Kmassidik/autonomous-computer/components/cpu/xeon-w5-3423/sources.md

# Sources — Intel Xeon w5-3423

Every dimension in `specs.json` and `index.html` traces to one of these.

## Autonomous 4×-6000 build README

- URL: <https://github.com/autonomous-ai/autonomous-computer/blob/main/4x-6000/README.md>
- Retrieved: 2026-10-02
- Covers: Core count, 112 PCIe 5.0 lanes, socket, stock cooler part number

## ASUS Pro WS W790E-SAGE SE tech spec

- URL: <https://www.asus.com/motherboards-components/motherboards/workstation/pro-ws-w790e-sage-se/techspec/>
- Retrieved: 2026-10-02
- Covers: Socket LGA4677 compatibility

## Not vendor-published

- Package dimensions
- Substrate thickness used in CAD
- IHS modelled as

These are JEDEC/ATX standard values or modelling estimates. They are good enough for
clearance checking and should not be quoted as manufacturer specifications.
