Kmassidik/autonomous-computer/components/gpu/rtx-3060ti/sources.md

# Sources — GeForce RTX 3060 Ti

Every dimension in `specs.json` and `index.html` traces to one of these.

## NVIDIA RTX 3060 / 3060 Ti product page

- URL: <https://www.nvidia.com/en-us/geforce/graphics-cards/30-series/rtx-3060-3060ti/>
- Retrieved: 2026-10-02
- Covers: Length, width, slot count, TGP, memory, bus width

## Not vendor-published

- Slot pitch used in CAD

These are JEDEC/ATX standard values or modelling estimates. They are good enough for
clearance checking and should not be quoted as manufacturer specifications.
