Kmassidik/autonomous-computer/components/gpu/rtx-5090/sources.md

# Sources — GeForce RTX 5090

Every dimension in `specs.json` and `index.html` traces to one of these.

## NVIDIA GeForce RTX 5090 product page

- URL: <https://www.nvidia.com/en-us/geforce/graphics-cards/50-series/rtx-5090/>
- Retrieved: 2026-10-02
- Covers: Length, width, slot count, TGP, memory, power connectors

## Not vendor-published

- Slot pitch used in CAD

These are JEDEC/ATX standard values or modelling estimates. They are good enough for
clearance checking and should not be quoted as manufacturer specifications.
