Kmassidik/autonomous-computer/components/gpu/rtx-pro-6000/sources.md

# Sources — RTX PRO 6000 Blackwell

Every dimension in `specs.json` and `index.html` traces to one of these.

## NVIDIA RTX PRO 6000 product page

- URL: <https://www.nvidia.com/en-us/products/workstations/professional-desktop-gpus/rtx-pro-6000/>
- Retrieved: 2026-10-02
- Covers: Dimensions, power, memory, bandwidth, connectors, cooling

## PNY RTX PRO 6000 Blackwell WS

- URL: <https://www.pny.com/nvidia-rtx-pro-6000-blackwell-ws>
- Retrieved: 2026-10-02
- Covers: Confirms 5.4 in × 12 in dual slot; power connector type

## Not vendor-published

- (none)

These are JEDEC/ATX standard values or modelling estimates. They are good enough for
clearance checking and should not be quoted as manufacturer specifications.
