Kmassidik/autonomous-computer/components/motherboard/asus-pro-ws-w790e-sage-se/sources.md

# Sources — ASUS Pro WS W790E-SAGE SE

Every dimension in `specs.json` and `index.html` traces to one of these.

## ASUS Pro WS W790E-SAGE SE tech spec

- URL: <https://www.asus.com/motherboards-components/motherboards/workstation/pro-ws-w790e-sage-se/techspec/>
- Retrieved: 2026-10-02
- Covers: Form factor and dimensions, socket, PCIe slot configuration, memory slots, capacity, supported types and speeds

## Not vendor-published

- PCB thickness used in CAD

These are JEDEC/ATX standard values or modelling estimates. They are good enough for
clearance checking and should not be quoted as manufacturer specifications.
