Kmassidik/autonomous-computer/components/ram/ddr5-4800-ecc-rdimm/sources.md

# Sources — DDR5-4800 ECC RDIMM

Every dimension in `specs.json` and `index.html` traces to one of these.

## Wikipedia — DIMM (JEDEC figures)

- URL: <https://en.wikipedia.org/wiki/DIMM>
- Retrieved: 2026-10-02
- Covers: 288-pin, 31.25 mm nominal height, 133.35 mm length, standard MO-329J

## ASUS Pro WS W790E-SAGE SE tech spec

- URL: <https://www.asus.com/motherboards-components/motherboards/workstation/pro-ws-w790e-sage-se/techspec/>
- Retrieved: 2026-10-02
- Covers: 8 DIMM slots, 2048 GB max, 8-channel, DDR5 ECC Registered, speed list

## Not vendor-published

- PCB thickness used in CAD

These are JEDEC/ATX standard values or modelling estimates. They are good enough for
clearance checking and should not be quoted as manufacturer specifications.
