Kmassidik/autonomous-computer/components/cpu/xeon-w5-3423/index.html

Socket | Intel LGA4677 (Xeon W-3400 / W-2400)
Cores | 12
PCIe 5.0 lanes | 112 — enough for four cards at full ×16
Package dimensions | 77.5 mm × 56.5 mm unverified
Substrate thickness used in CAD | 1.1 mm estimate
IHS modelled as | 58 × 42 × 2.6 mm estimate
Stock cooler in BOM | Heatsink 4677-2UAF8 (2U active)
model.step — envelope | Block geometry at true outer dimensions. Small, fast, and all you need to answer does it fit.
model-detailed.step — detailed | 77.5 × 56.5 × 3.82 mm · 1771 faces · 11.3 cm³ · 2019 KB
Solid integrity | valid, closed manifold — boolean interference tests will work against it
Autonomous 4×-6000 build README (https://github.com/autonomous-ai/autonomous-computer/blob/main/4x-6000/README.md) | Core count, 112 PCIe 5.0 lanes, socket, stock cooler part number
ASUS Pro WS W790E-SAGE SE tech spec (https://www.asus.com/motherboards-components/motherboards/workstation/pro-ws-w790e-sage-se/techspec/) | Socket LGA4677 compatibility
