Kmassidik/autonomous-computer/2x-5090/assembly/housing-2x-box--RTX5090-and-RTXPRO6000.step

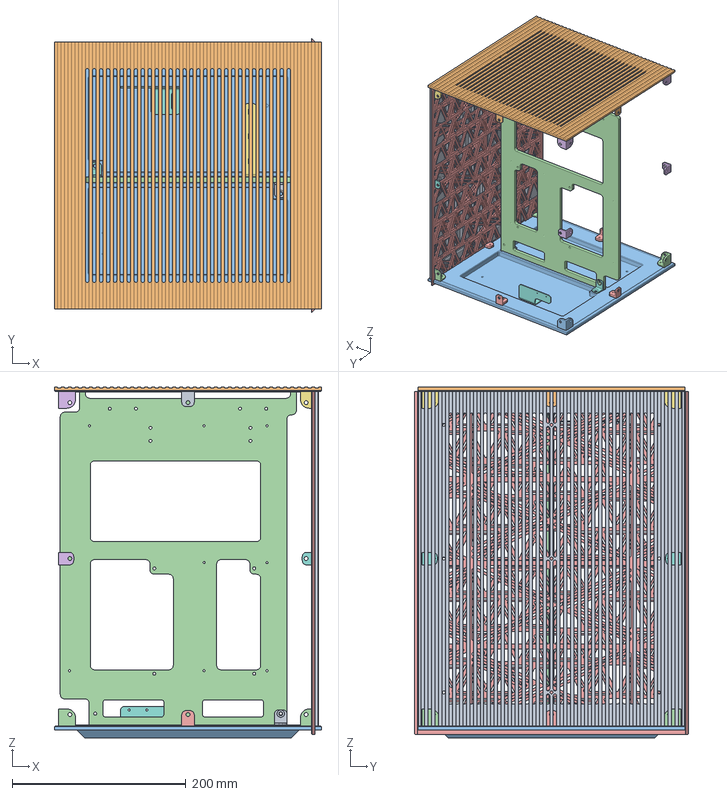
[picture p1: CAD file, 2026-10-02]
2x-5090/assembly/housing-2x-box--RTX5090-and-RTXPRO6000.step
307.6 x 315.0 x 404.0 mm
