Kmassidik/autonomous-computer/2x-5090/drawings/dxf/Part 5 - Middle.dxf

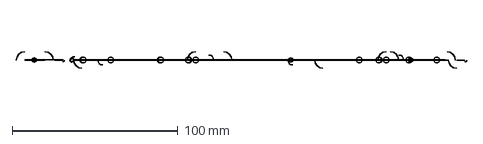
[picture p2: CAD file, 2026-10-02]
2x-5090/drawings/dxf/Part 5 - Middle.dxf
271.9 x 10.0 mm
