Kmassidik/autonomous-computer/4x-5090/assembly/housing-4x-cube--RTX5090-and-RTXPRO6000.step

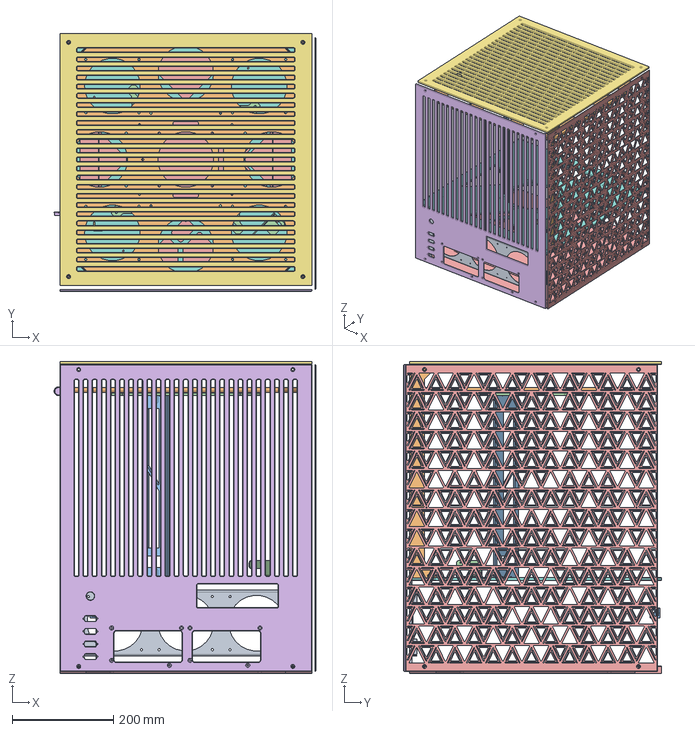
[picture p3: CAD file, 2026-10-02]
4x-5090/assembly/housing-4x-cube--RTX5090-and-RTXPRO6000.step
517.4 x 509.9 x 616.5 mm
