Kmassidik/autonomous-computer/4x-5090/drawings/dxf/Part 5 - Corner 1.dxf

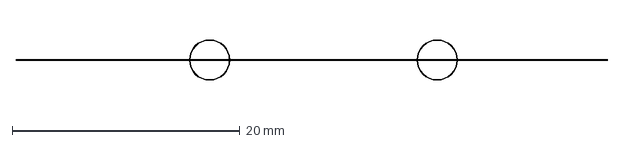
[picture p4: CAD file, 2026-10-02]
4x-5090/drawings/dxf/Part 5 - Corner 1.dxf
52.0 x 3.50 mm
