Kmassidik/autonomous-computer/4x-5090/step_models/Part 2 - Back--CORRECTED-placement.step

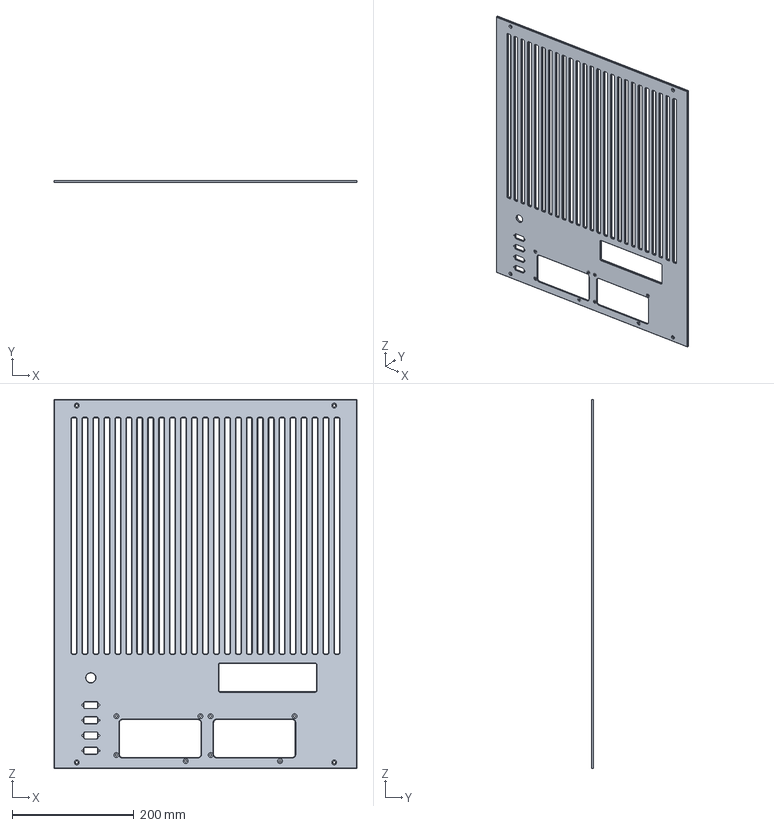
[picture p5: CAD file, 2026-10-02]
4x-5090/step_models/Part 2 - Back--CORRECTED-placement.step
498.0 x 4.00 x 606.5 mm
