Kmassidik/autonomous-computer/components/cpu/xeon-w5-3423/model.step

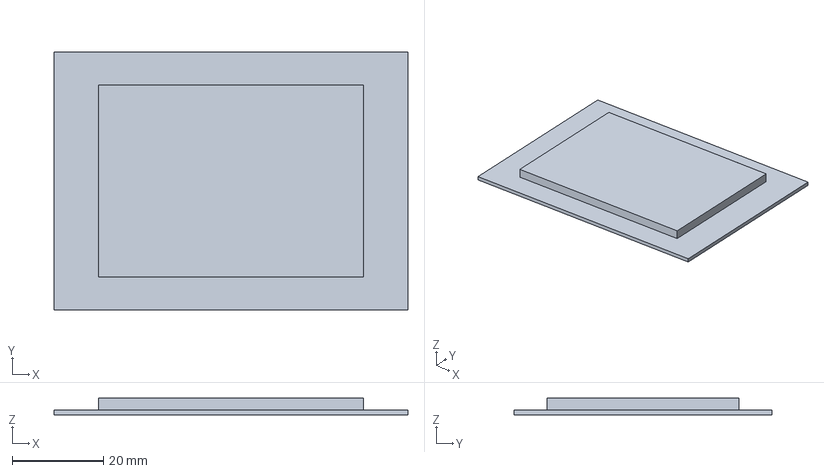
[picture p6: CAD file, 2026-10-02]
components/cpu/xeon-w5-3423/model.step
77.5 x 56.5 x 3.70 mm
