Kmassidik/autonomous-computer/components/gpu/rtx-3060ti/model.step

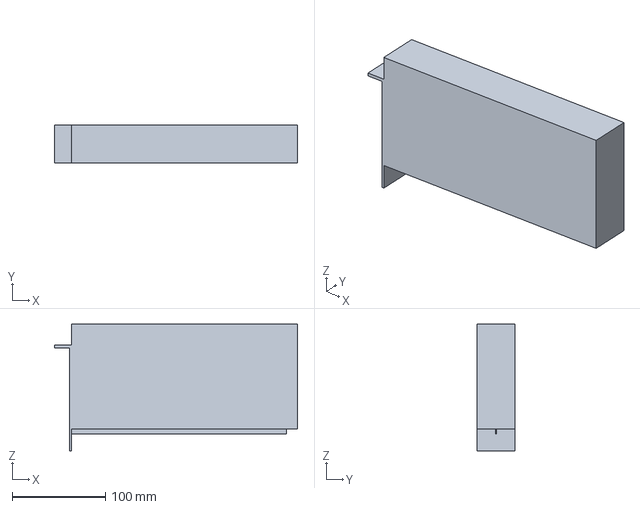
[picture p7: CAD file, 2026-10-02]
components/gpu/rtx-3060ti/model.step
260.0 x 40.6 x 135.6 mm
