Kmassidik/autonomous-computer/components/gpu/rtx-5090/model.step

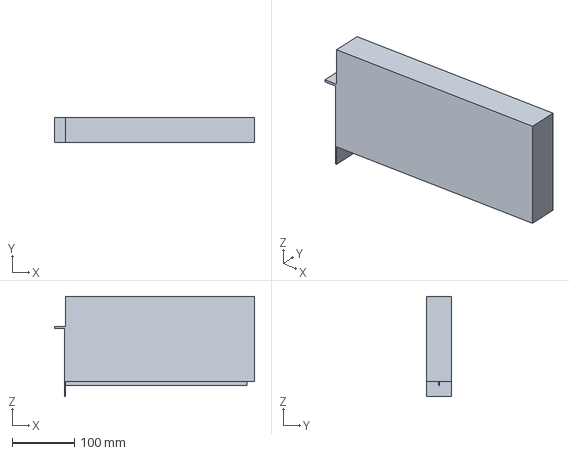
[picture p8: CAD file, 2026-10-02]
components/gpu/rtx-5090/model.step
322.0 x 40.6 x 161.8 mm
