Kmassidik/autonomous-computer/components/gpu/rtx-pro-6000/model-detailed.step

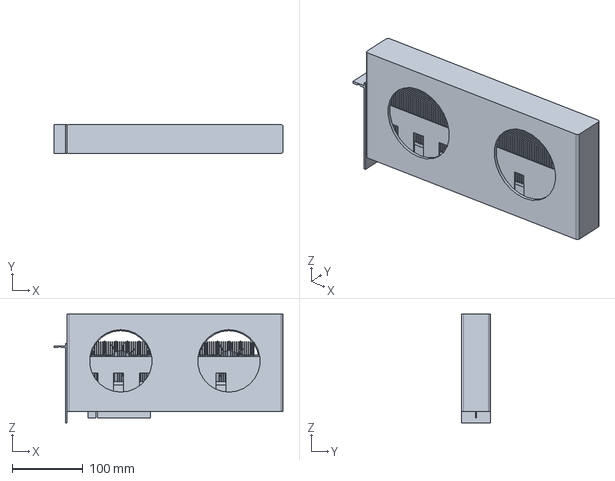
[picture p9: CAD file, 2026-10-02]
components/gpu/rtx-pro-6000/model-detailed.step
322.8 x 40.6 x 153.2 mm
