Kmassidik/autonomous-computer/components/motherboard/asus-pro-ws-w790e-sage-se/model-detailed.step

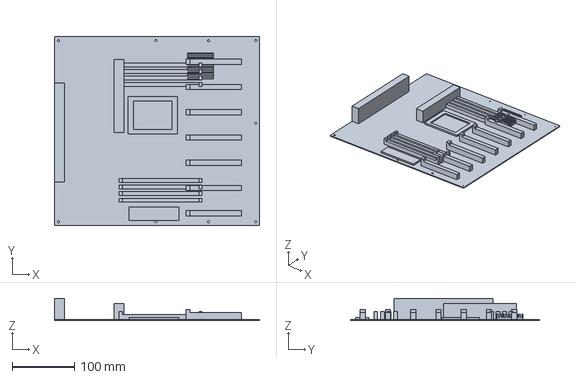
[picture p10: CAD file, 2026-10-02]
components/motherboard/asus-pro-ws-w790e-sage-se/model-detailed.step
330.1 x 305.0 x 35.6 mm
