Kmassidik/autonomous-computer/components/ram/ddr5-4800-ecc-rdimm/model-detailed.step

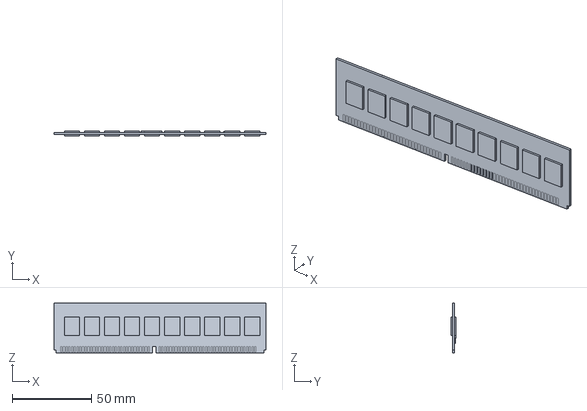
[picture p11: CAD file, 2026-10-02]
components/ram/ddr5-4800-ecc-rdimm/model-detailed.step
133.3 x 3.30 x 31.2 mm
