Kmassidik/autonomous-computer/2x-5090/drawings/dxf/Part 10 - Side cover.dxf

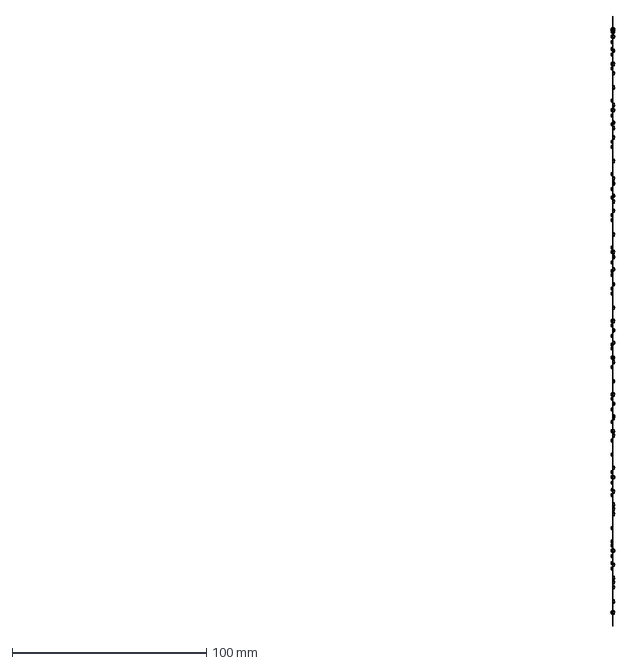
[picture p12: CAD file, 2026-10-02]
2x-5090/drawings/dxf/Part 10 - Side cover.dxf
308.2 x 314.0 mm
