Kmassidik/autonomous-computer/4x-5090/drawings/dxf/Part 3 - Top.dxf

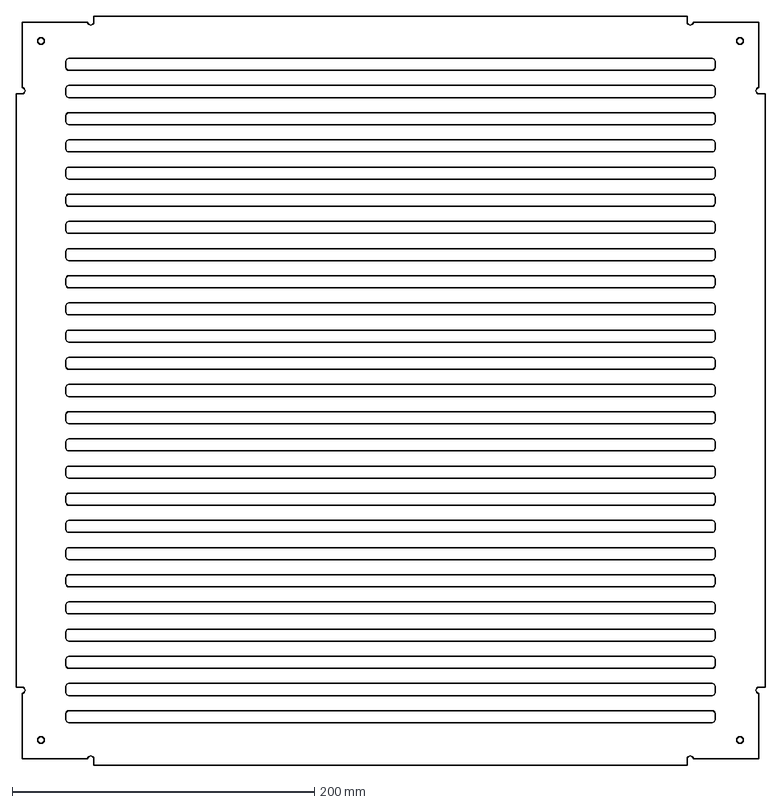
[picture p13: CAD file, 2026-10-02]
4x-5090/drawings/dxf/Part 3 - Top.dxf
496.0 x 496.0 mm
