Kmassidik/autonomous-computer/components/cpu/xeon-w5-3423/model-detailed.step

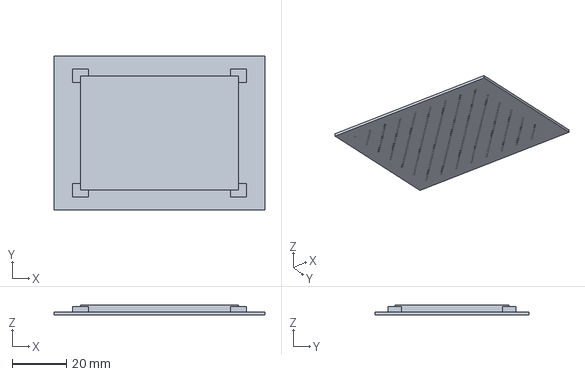
[picture p14: CAD file, 2026-10-02]
components/cpu/xeon-w5-3423/model-detailed.step
77.5 x 56.5 x 3.82 mm
