Kmassidik/autonomous-computer/components/gpu/rtx-3060ti/model-detailed.step

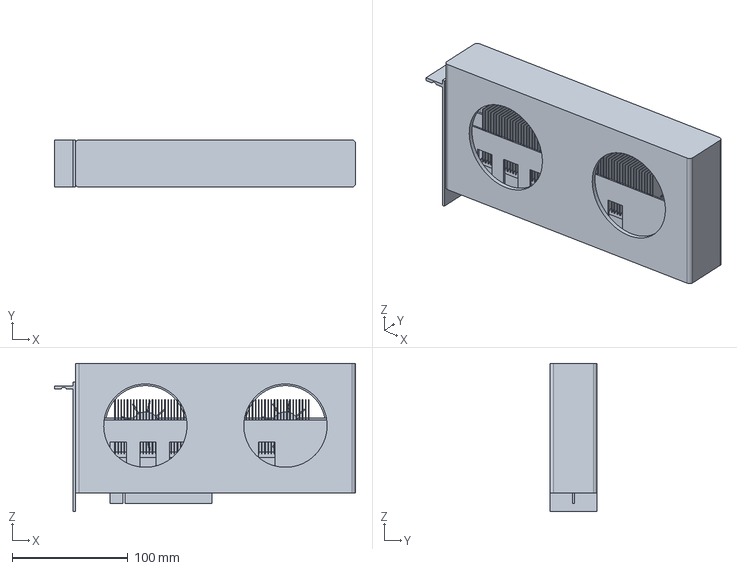
[picture p15: CAD file, 2026-10-02]
components/gpu/rtx-3060ti/model-detailed.step
260.0 x 40.6 x 128.0 mm
