Kmassidik/autonomous-computer/components/motherboard/asus-pro-ws-w790e-sage-se/model.step

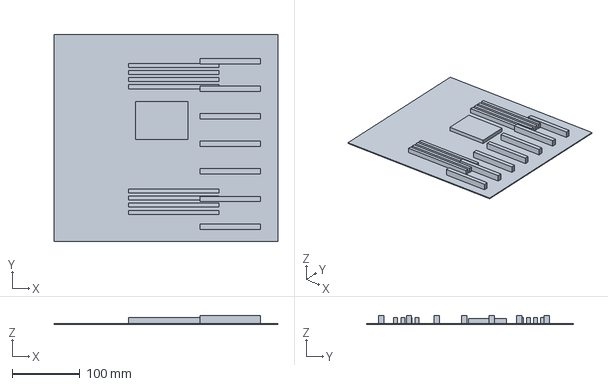
[picture p16: CAD file, 2026-10-02]
components/motherboard/asus-pro-ws-w790e-sage-se/model.step
330.0 x 305.0 x 13.1 mm
