Kmassidik/autonomous-computer/components/ram/ddr5-4800-ecc-rdimm/model.step

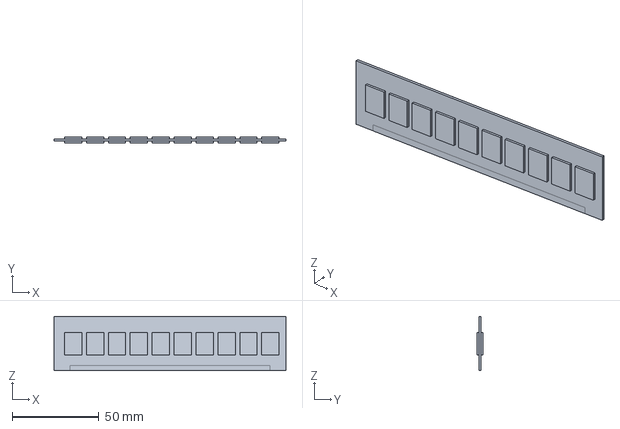
[picture p17: CAD file, 2026-10-02]
components/ram/ddr5-4800-ecc-rdimm/model.step
133.3 x 3.40 x 31.2 mm
