Kmassidik/autonomous-computer/2x-5090/drawings/dxf/Part 3 - Top.dxf

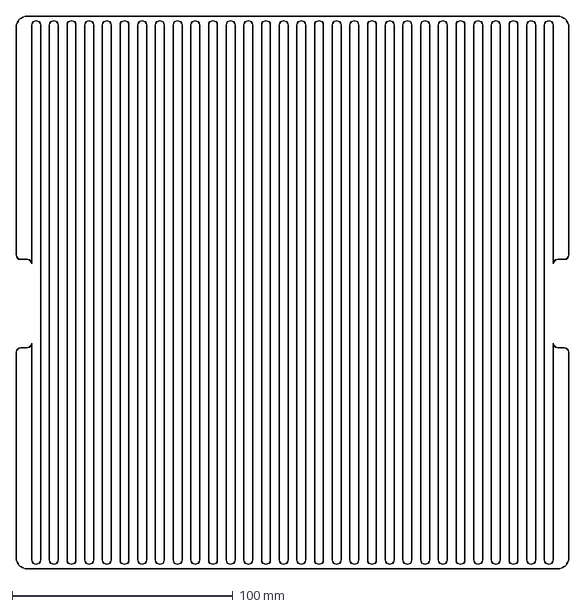
[picture p18: CAD file, 2026-10-02]
2x-5090/drawings/dxf/Part 3 - Top.dxf
250.0 x 250.0 mm
