Kmassidik/autonomous-computer/4x-5090/drawings/dxf/Part 10 - Button.dxf

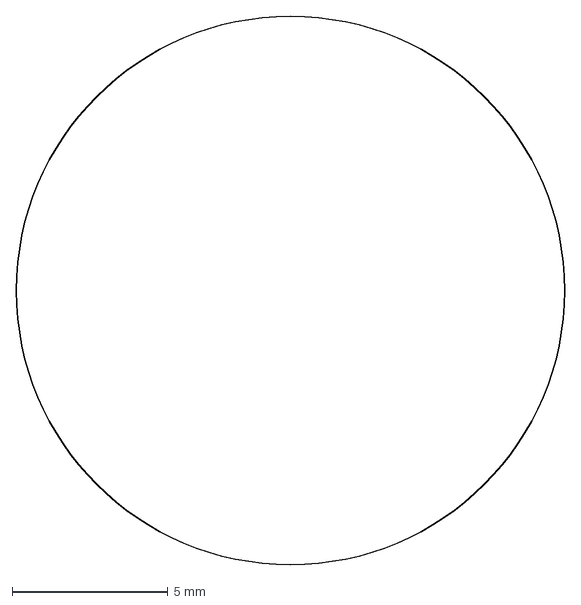
[picture p19: CAD file, 2026-10-02]
4x-5090/drawings/dxf/Part 10 - Button.dxf
17.6 x 17.6 mm
