Kmassidik/autonomous-computer/2x-5090/drawings/dxf/Part 1 - Side.dxf

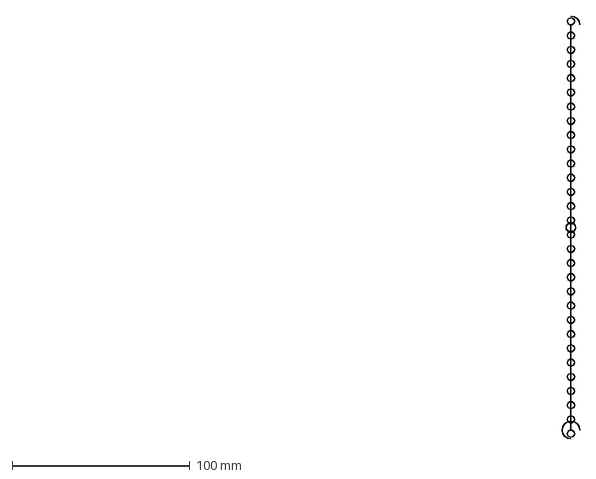
[picture p20: CAD file, 2026-10-02]
2x-5090/drawings/dxf/Part 1 - Side.dxf
317.2 x 238.0 mm
