Kmassidik/autonomous-computer/4x-5090/drawings/dxf/3 Fan mount.dxf

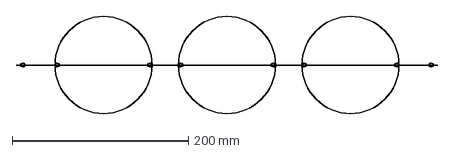
[picture p21: CAD file, 2026-10-02]
4x-5090/drawings/dxf/3 Fan mount.dxf
478.0 x 110.0 mm
