Kmassidik/autonomous-computer/4x-5090/drawings/dxf/Part 4 - Middle.dxf

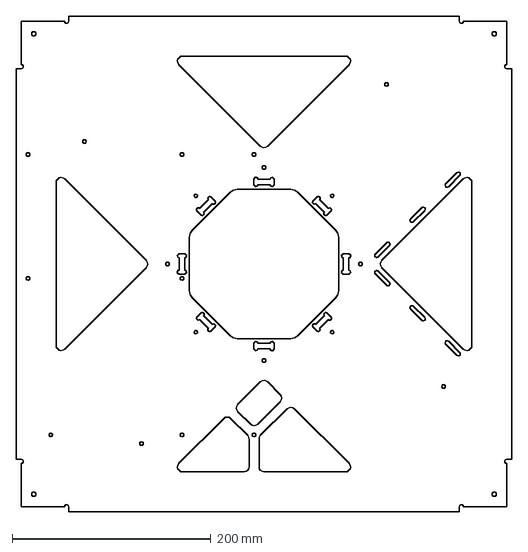
[picture p22: CAD file, 2026-10-02]
4x-5090/drawings/dxf/Part 4 - Middle.dxf
498.0 x 498.0 mm
