Kmassidik/autonomous-computer/4x-5090/drawings/dxf/Part 2 - Back.dxf

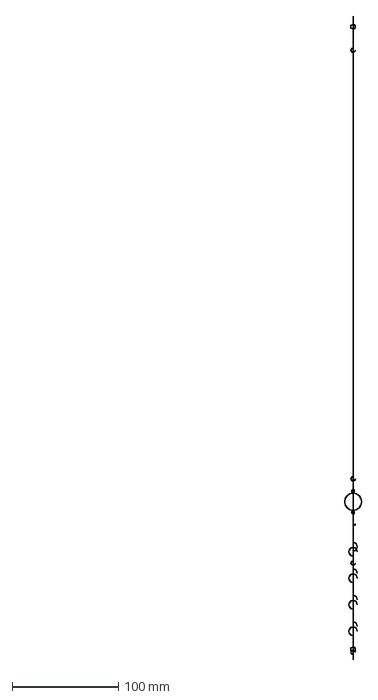
[picture p23: CAD file, 2026-10-02]
4x-5090/drawings/dxf/Part 2 - Back.dxf
325.2 x 606.5 mm
