Kmassidik/autonomous-computer/4x-5090/drawings/dxf/9 Fan mount.dxf

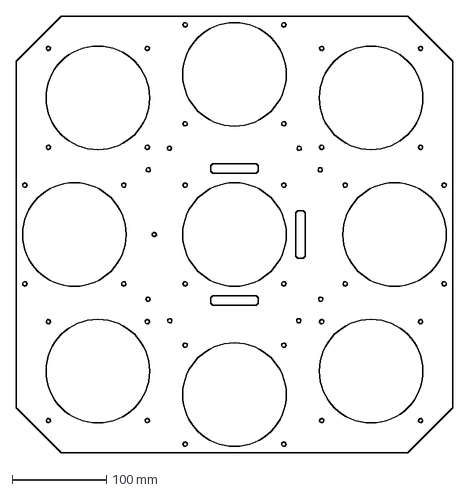
[picture p24: CAD file, 2026-10-02]
4x-5090/drawings/dxf/9 Fan mount.dxf
464.0 x 464.0 mm
