Kmassidik/autonomous-computer/4x-5090/drawings/dxf/Part 9 - Side.dxf

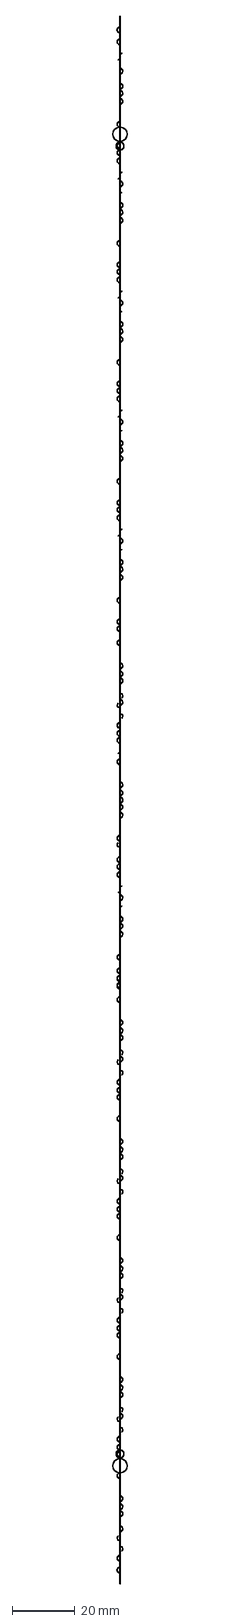
[picture p25: CAD file, 2026-10-02]
4x-5090/drawings/dxf/Part 9 - Side.dxf
4.50 x 498.0 mm
