Kmassidik/autonomous-computer/4x-5090/drawings/dxf/Part 6 - Corner 2.dxf

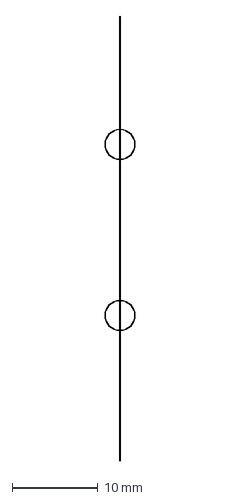
[picture p26: CAD file, 2026-10-02]
4x-5090/drawings/dxf/Part 6 - Corner 2.dxf
3.50 x 52.0 mm
