Kmassidik/autonomous-computer/4x-5090/drawings/dxf/Part 8 - GPU Holder 2.dxf

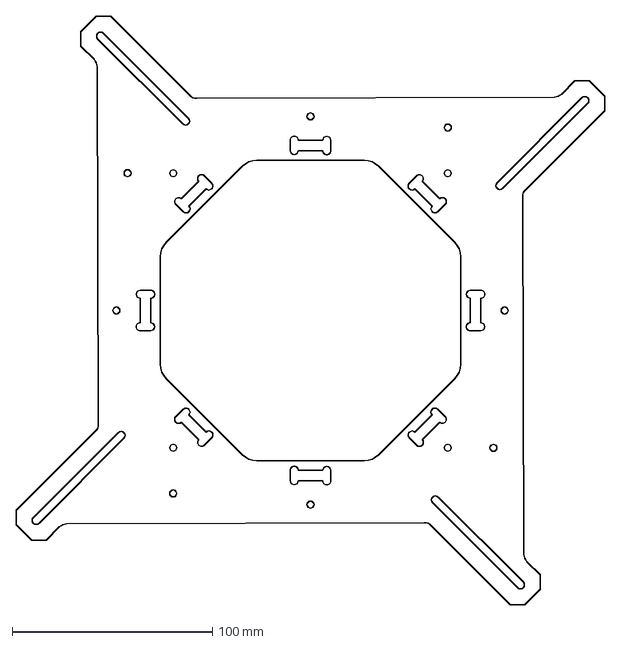
[picture p27: CAD file, 2026-10-02]
4x-5090/drawings/dxf/Part 8 - GPU Holder 2.dxf
294.0 x 294.0 mm
