Kmassidik/autonomous-computer/(list of files, cad)

Other CAD files:
components/gpu/rtx-5090/model-detailed.step
components/gpu/rtx-pro-6000/model.step
