Kmassidik/autonomous-computer/(commit log)

2026-10-02 Add 4x cube assembled model, drawings, and a Part 2 - Back correction
    The 4x and 2x housings are published as individual parts only. Each part
    already carries its assembly coordinates, so an assembled model is a
    compound rather than a fitting job.
    Building it surfaced two parts sitting outside the frame: assembling the
    published parts as-is gives an 888.3 mm envelope instead of 616.5 mm.
    Part 2 - Back is stored rotated 90 degrees and 271.8 mm high. As published
    it is 4.0 x 606.5 x 498.0 mm, with its 606.5 mm axis along Y; a wall of
    this frame needs that axis vertical, since the frame is 616.5 mm tall and
    Part 9 - Side spans exactly 606.5 mm in Z. Rotating 120 degrees about
    (1,1,1) gives 49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
    [3 Fan mount.dxf, 4x-cube-ASSEMBLY.step, 9 Fan mount.dxf, Part 10 - Button.dxf, Part 2 - Back - CORRECTED.step, Part 2 - Back.dxf, Part 3 - Top.dxf, Part 4 - Middle.dxf]
2026-10-02 Add 2x box assembled model and drawings
    Same treatment as the 4x cube: an assembled STEP built from the published
    parts, plus dimensioned drawings and DXF for the sheet work.
    Unlike the 4x, this housing has no placement faults. Every part is already
    in its correct assembly position, and the result is 307.6 x 315.0 x 404.0 mm
    (12.1 x 12.4 x 15.9 in) against the 12.5 x 12.5 x 16 in in the build README.
    Two files in step_models are not what their names suggest, which is worth
    knowing before anyone tries to cut or print them.
    Part 2 - Back.step is not a panel. It holds 127 solids measuring
    398 x 315 x 168 mm: a 163 x 86 x 150 mm power supply, two 130 mm fans, two
    110 mm fans, and assorted sma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
    [2x-box-ASSEMBLY.step, Part 1 - Side.dxf, Part 10 - Side cover.dxf, Part 3 - Top.dxf, Part 5 - Middle.dxf]
2026-10-02 Name the housing files after the cards they serve
    The assembly files were named after the frame alone, which says nothing about
    which build they belong to. Renamed to state both cards explicitly:
    housing-4x-cube--RTX5090-and-RTXPRO6000.step
    housing-2x-box--RTX5090-and-RTXPRO6000.step
    Part 2 - Back--CORRECTED-placement.step
    Both names carry two cards on purpose. Upstream publishes no step_models under
    4x-6000/ or 2x-6000/; those READMEs point at the 5090 folders, so one CAD set
    is the housing for both variants.
    That deserved checking, since the two cards are not the same object. It holds
    because the frame never touches the card body. In the 4x cube the GPUs are
    carried by a 50.2 x 50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
    [Part 2 - Back--CORRECTED-placement.step, housing-2x-box--RTX5090-and-RTXPRO6000.step, housing-4x-cube--RTX5090-and-RTXPRO6000.step]
2026-10-02 Add component library: specs, sources and CAD for the parts in the builds
    Six components, each in its own folder with the same five files: index.html,
    model.step, model-detailed.step, specs.json and sources.md.
    The point is to be able to answer "will this card clear the housing" before
    cutting metal or buying anything. The housing assemblies already added under
    4x-5090/assembly and 2x-5090/assembly have nothing to check against on their
    own.
    Dimensions are taken from manufacturer pages, retrieved 2026-10-02:
    RTX 5090 FE 304 x 137 mm, 2-slot, 575 W, 32 GB GDDR7
    RTX PRO 6000 WS 304.8 x 137.2 mm, dual slot, 600 W, 96 GB GDDR7 ECC
    RTX 3060 Ti FE 242 x 112 mm, 2-slot,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
    [model-detailed.step, model.step]
